krivanikm/mnpk01-soc/docs/schematics.md

---
title: Schematics
---

# Schematics

RTL schematics generated from the SystemVerilog code by **Yosys** (`make schematics` in `rtl/`).
Every block is drawn the way the synthesizer understands it: adders, multiplexers, registers and the wires between them.
Each schematic is an SVG, so it stays sharp at any zoom.

<p class="sv-hint">drag to move · + / − or Ctrl + wheel to zoom · double-click to zoom in · ⛶ fullscreen (the wheel zooms there)</p>

<figure class="schem">
  
  <figcaption><b>system_top</b> – how the control unit, register file, ALU, program counter and data RAM are connected. Note <code>r1_out</code> going straight into the <code>op</code> input of the ALU.</figcaption>
</figure>

<figure class="schem">
  
  <figcaption><b>Program counter</b> – a +1 adder, two multiplexers and a 16-bit register. The <code>pc_inc</code> multiplexer is closer to the register, so it has priority over <code>pc_load</code>.</figcaption>
</figure>

<figure class="schem">
  
  <figcaption><b>ALU</b> – the arithmetic and logic operations computed in parallel and a large multiplexer that picks one result by <code>op</code>.</figcaption>
</figure>

<figure class="schem">
  
  <figcaption><b>Control unit</b> – the state machine, the instruction register and the flags.</figcaption>
</figure>

<figure class="schem">
  
  <figcaption><b>Register file</b> – 16 × 16-bit registers and the multiplexer that selects the register being read. This is the largest block of the CPU.</figcaption>
</figure>

<figure class="schem">
  
  <figcaption><b>Data RAM</b> – a memory array with a write port and a registered read. The synthesizer maps it to FPGA block RAM.</figcaption>
</figure>

<figure class="schem">
  
  <figcaption><b>Whole CPU</b> – everything above flattened into a single diagram. Very large – use fullscreen and zoom in.</figcaption>
</figure>

## FPGA resources

Synthesis for the Gowin GW1NR-9 (Tang Nano 9K) with Yosys `synth_gowin`:

| Resource | CPU | Tang Nano 9K | Usage |
|---|---|---|---|
| Flip-flops | 396 | 6 480 | ~6 % |
| LUTs | 1 197 | 8 640 | ~14 % |
| Block RAM (BSRAM) | 4 | 26 | ~15 % |

Most of it is the register file: 256 bits of state and a 16-to-1 multiplexer 16 bits wide.
Most of the ~670 single-input LUTs are only constant helper inputs for the wide multiplexers that Yosys adds for Gowin; the real logic (LUT2 – LUT4) is about 530 LUTs.
The data RAM (4096 × 16 bits) takes 4 block RAMs and no flip-flops.

<script src="{{ '/assets/js/schem.js' | relative_url }}?v=1.3"></script>
