krivanikm/mnpk01-soc/docs/index.md

---
title: Home
---

# MNPK-01

**MNPK-01** is a 16-bit microcontroller designed from the logic level in SystemVerilog all the way to a physical printed circuit board.
The goal of the project is to cover the whole chain of computer design: a custom instruction set architecture (ISA), its hardware
implementation, verification by simulation, deployment on an FPGA and finally a custom PCB.

## Key parameters

| Parameter | Value |
|---|---|
| Data width | 16 bits (registers, ALU) |
| Address width | 16 bits |
| Instruction width | 16 bits (1 instruction = 1 word) |
| Registers | 16 × 16 bits (R0 – R15) |
| Data memory | 4096 × 16 bits RAM (FPGA block RAM), word-addressed |
| Architecture | Harvard – separate program and data memory |
| Input / output | memory-mapped at `0xFF00` – `0xFFFF`: 16-bit output port, 16-bit input port, UART transmitter and receiver |
| Program storage | FPGA BRAM, initialised from a hex file in the bitstream, new programs uploaded over UART |

## Project status

| Part | Status |
|---|---|
| ALU | done, 16-bit, 14 operations, ~40 million checks (edge and random values) |
| Register file | done |
| Program counter | done, connected in `system_top` |
| Control unit | all 9 instructions work (NOP, MVI, MOV, MVIB, LOAD, STORE, JMP, ALU, HLT), also with FPGA BRAM |
| ALU instruction (via register R1) | done |
| Jumps (JMP + 6 conditions) | done – loops and decisions work |
| LOAD/STORE + data RAM | done – arrays in memory work |
| Automated tests | 28/28 pass in both memory modes |
| I/O port | done – `STORE` to `0xFF00` drives the output, `LOAD` from `0xFF01` reads the input |
| UART transmitter | done – `STORE` to `0xFF01` sends a byte, `LOAD` from `0xFF02` reads `busy`, "Hello World" runs on the board |
| UART receiver | done – `LOAD` from `0xFF04` reads `rx_ready`, `LOAD` from `0xFF03` reads the byte, an echo program runs on the board |
| Program loader over UART | done – `MNPK` packet with length and XOR checksum, `tools/upload.py` loads a program into the running board |
| HLT instruction | done – stops the CPU, the board shows it on an LED |
| Assembler (`tools/asm/mnasm`) | done – C++, two passes, labels |
| New instructions (BR, ADDI, JAL) | next |
| Synthesis (Yosys) | design fits a Tang Nano 9K with ~14 % of its LUTs and 4 of 26 block RAMs, see [Schematics](schematics.html) |
| FPGA | done – the CPU runs on a Tang Nano 9K (LEDs, switches and UART through the I/O port), see [FPGA](fpga.html) |
| PCB | planned |
