krivanikm/mnpk01-soc/docs/simulation.md

---
title: Simulation
---

# Simulation and testing

The design is verified with the **Verilator** simulator, testbenches are written in C++.

## ALU test

File: `rtl/alu/sim_main.cpp`

With 16-bit operands there are too many combinations to try them all (65536 × 65536 per operation), so for every operation it tests:

1. all 65536 values of `a` against edge values of `b` (`0`, `1`, `0x7F`, `0x80`, `0xFF`, `0x100`, `0x7FFF`, `0x8000`, `0xFFFF`, …),
2. edge values of `a` against all 65536 values of `b`,
3. one million random pairs (with a fixed seed, so the test is always the same).

That is about **40 million checks**; both the result and the flags are compared with the values computed in C++.
Run it with `make alu` in `rtl/`.

## Full system test

Files: `rtl/tb_full_system.cpp`, `rtl/tests/*.txt`

Every test is a short program in its own text file together with the expected result:

```
1100    ; MVI R1, 0      (ADD)
123B    ; MVI R2, 59
1331    ; MVI R3, 49
7234    ; ALU R2, R3, R4
expect r2=59 r3=49 r4=108
```

The testbench loads the program, runs it and at the end compares the **actual contents of all 16 registers**
with the expected values. A register that is not listed must be 0, so a write to a wrong register is caught too.
It also checks the final PC and stops a program that gets stuck.
A test can also check the data RAM, e.g. `expect mem[0x10]=42` (only the listed addresses are checked).
The I/O ports work the same way: the line `io_in 0xA5C3` sets the input pins and `expect io_out=0x1234` checks the output register at the end of the test (a test that does not list `io_out` expects 0, so a stray write to the port is caught).

Every test runs in **both memory modes**:

| Mode | Behaviour |
|---|---|
| combinational | the instruction is available immediately |
| synchronous (BRAM) | like real FPGA block RAM: data arrive one cycle after the address |

The program counter is real hardware (`programcounter.v` in `system_top`); the testbench only emulates the program memory and serves it the instruction at address `pc`.

### Tests

| Test | What it checks |
|---|---|
| `basic` | MVI, MVIB, MOV, NOP together |
| `mvi_mvib` | 16-bit constants, registers R0 and R15, overwriting a value |
| `mov` | MOV copies all 16 bits, chaining, MOV to itself |
| `nop_unimplemented` | NOP and unknown opcodes (`0x8` – `0xF`) do not hang the CPU |
| `alu_add` | 59 + 49 = 108 |
| `alu_ops` | SUB, AND, OR, XOR, operation in R1 changed between instructions |
| `alu_sub_borrow` | subtraction below zero, subtraction to zero |
| `alu_cmp` | CMP does not write to Rd |
| `alu_rd_eq_src` | destination equal to a source register |
| `alu_unary` | INC, DEC, NOT, SHL, SHR, ROL, PASS, CLR |
| `alu_high_byte` | the ALU uses the high bytes of the operands and overwrites the whole Rd |
| `alu_carry16` | carry / borrow between the low and high byte, 16-bit overflow |
| `alu_op_runtime` | the ALU writes into R1 and so selects the next operation |
| `jmp_always` | unconditional jump forwards and backwards, skipped instructions are not executed |
| `jmp_cond` | all 6 conditions after CMP, each one taken and not taken; an unknown condition never jumps |
| `jmp_loop` | a loop: 6 × 7 = 42 by repeated addition, JNZ on the Z flag from SUB |
| `mem_store_load` | STORE and LOAD back, the same register as address and data, LOAD into the address register |
| `mem_back_to_back` | LOAD right after STORE and vice versa, swapping two values in memory |
| `mem_array` | an array of 5 numbers in RAM summed in a loop (LOAD + JMP) = 150 |
| `io_write` | `STORE` to `0xFF00` sets `io_out` and does not write into the RAM (it would alias to `0x0F00`) |
| `io_unmapped` | `STORE` to `0xFF01` (the UART data port) changes neither `io_out` nor the RAM |
| `io_and_ram` | a write to the port and a write to the RAM do not mix |
| `io_read` | `LOAD` from `0xFF01` returns `io_in` |
| `io_read_ram_mix` | alternating `LOAD` from the port and from the RAM, the port selection does not stay latched |
| `uart_send_busy` | `STORE` to `0xFF01` starts the UART (`busy` = 1 on the next `LOAD` from `0xFF02`) and nothing is written into the RAM |
| `uart_status_idle` | `LOAD` from `0xFF02` before any transmission returns `busy` = 0 |
| `uart_recv` | the CPU waits for `rx_ready`, reads a received byte from `0xFF03` and `rx_ready` is 0 afterwards |
| `uart_recv_two` | two bytes in a row; the second one arrives while the CPU is busy in a delay loop and its `rx_ready` must not be lost |

### Running

In the `rtl/` directory:

```
make test        # all tests, both memory modes
make test V=1    # with a cycle-by-cycle trace
make alu         # standalone ALU test
make uart        # standalone UART transmitter and receiver tests
```

Current result: **28/28 tests pass** in both modes.

### UART test

File: `rtl/uart/tb_uart_tx.cpp`

The transmitter is tested alone, with `CLKS_PER_BIT` = 16 so the simulation is short. For a set of bytes the testbench sends the byte,
samples the `tx` line in the middle of every bit and checks the start bit (0), the 8 data bits (least significant first) and the stop bit (1),
and also that `busy` is high for the whole frame and low again afterwards.

### UART receiver test

File: `rtl/uart/tb_uart_rx.cpp`

The receiver is tested alone, also with `CLKS_PER_BIT` = 16. The testbench drives the `rx` line with a start bit, 8 data bits (least significant first) and a stop bit, each held for `CLKS_PER_BIT` clocks, and checks that `valid` pulses exactly once and `data` equals the sent byte.
It sends the bytes 0x41, 0x55, 0xAA, 0x00, 0xFF, 0x80 and 0x01, then a start bit lasting only a quarter of the bit time (a glitch that must be rejected), and finally two frames back to back, which must give two `valid` pulses.

In the full-system testbench (`tb_full_system.cpp`) the line `rx 0x5A 0xA5` in a test file drives `uart_rx_pin` with those bytes, one frame after another, starting at clock 50.
