krivanikm/mnpk01-soc/docs/architecture.md

---
title: Architecture
---

# Architecture

```
              +-----------------+
   UART boot- |  Program memory | 16-bit instruction
   loader --> |     (BRAM)      | ------------------+
              +-----------------+                   |
                       ^ 16-bit address             v
              +-----------------+          +-----------------+  address, data  +-----------------+
              | Program counter | <------- |  Control unit   | <-------------> |    Data RAM     |
              +-----------------+   jump   +-----------------+   LOAD/STORE    | 4K x 16 (BRAM)  |
                                             |      |      ^                   +-----------------+
                                   control   |      |      | flags Z/C/N
                                             v      v      |
                                  +---------------+  +-----------+
                                  | Register file |<>|    ALU    |
                                  |  16 x 16 bit  |  |  16 bit   |
                                  +---------------+  +-----------+
```

The control unit drives all blocks directly, there is no bus-management unit between them.
The ALU takes its operation code straight from register R1 (see [ALU](alu.html)).

## Program counter

File: `rtl/program-counter/programcounter.v`

A 16-bit register holding the address of the current instruction.

| Signal | Direction | Meaning |
|---|---|---|
| `clk`, `rst` | input | clock, asynchronous reset (PC = 0) |
| `pc_inc` | input | PC = PC + 1 |
| `pc_load` | input | PC = `d_in` (jump) |
| `d_in[15:0]` | input | jump target address |
| `pc[15:0]` | output | current address |

If `pc_inc` and `pc_load` are both 1, `pc_inc` wins – the jump is not taken.
The control unit never sets both at once: `pc_inc` only in `S_FETCH`, `pc_load` only in `S_JMP`.
The program counter is part of `system_top`; its output `pc` is the address for the program memory.

## Register file

File: `rtl/registers/register_file.sv`

16 registers of 16 bits each. A register is always **read as a whole 16-bit word**.
Writing has two enable bits, one per byte, so the control unit can write the low byte (MVI),
the high byte (MVIB) or the whole word (MOV, ALU).

| Signal | Direction | Meaning |
|---|---|---|
| `clk`, `rst_n` | input | clock, asynchronous active-low reset, clears all registers |
| `addr[3:0]` | input | register number R0 – R15 |
| `d_in[15:0]` | input | data to write |
| `write_en[1:0]` | input | write on the rising clock edge: `01` = low byte `[7:0]`, `10` = high byte `[15:8]`, `11` = whole word |
| `q_out[15:0]` | output | register read (combinational, valid right after the address changes) |
| `r1_out[3:0]` | output | `R1[3:0]`, wired straight to the ALU as the operation code |

## Data RAM

File: `rtl/memory/data_ram.sv`

4096 words of 16 bits, implemented in FPGA block RAM (4 BSRAM blocks on the Tang Nano 9K).
It is **synchronous**: both write and read happen on the rising clock edge, so read data are valid one cycle after the address.
The memory array has no reset on purpose – with a reset the synthesizer could not map it to block RAM and would use
65 536 flip-flops instead.

| Signal | Direction | Meaning |
|---|---|---|
| `clk` | input | clock |
| `addr[11:0]` | input | word address (the low 12 bits of the address from the register) |
| `din[15:0]` | input | data to write |
| `we` | input | 1 = write `din` to `addr` on the rising edge |
| `dout[15:0]` | output | data read from `addr`, valid one cycle later |

The RAM only sees the low 12 bits of the address; the I/O area `0xFF00` – `0xFFFF` is decoded in `system_top` before the RAM (see [Input / output](#input--output)).

## Input / output

Input and output are **memory-mapped**: the same `LOAD` and `STORE` instructions that access the RAM also reach the ports, there is no separate I/O instruction.
`system_top` decodes the full 16-bit address of the memory access:

```
io_sel = (mem_addr[15:8] == 8'hFF)          the address is in 0xFF00 – 0xFFFF
RAM write enable = mem_we && !io_sel         a STORE to the I/O area never writes into the RAM
io_out <= mem_wdata   when mem_we && mem_addr == 16'hFF00
```

| Port | Direction | Address | Description |
|---|---|---|---|
| `io_out[15:0]` | output | `0xFF00` (STORE) | a 16-bit register, reset to 0 |
| `io_in[15:0]` | input | `0xFF01` (LOAD) | value of the pins, read through the multiplexer |
| UART data | output | `0xFF01` (STORE) | the low byte is sent over the `uart_tx_pin` pin; ignored while the UART is busy |
| UART status | input | `0xFF02` (LOAD) | bit 0 = `busy` (1 while a byte is being sent), the other bits are 0 |
| UART receive data | input | `0xFF03` (LOAD) | the low 8 bits = the last received byte; reading it clears `rx_ready` |
| UART receive status | input | `0xFF04` (LOAD) | bit 0 = `rx_ready` (1 = a new byte is waiting), the other bits are 0 |

`0xFF01` has a different meaning for each direction: `STORE` starts the UART, `LOAD` reads the input pins.
Any `LOAD` from the I/O area except `0xFF02` – `0xFF04` returns `io_in`, the address is not decoded more precisely.

**Read path.** The RAM is synchronous, so LOAD waits one cycle for the data (`S_LOAD_WAIT`). The input port has to answer with the same delay:
`system_top` registers both `io_sel` and `io_in` in the cycle in which the RAM latches the address and then selects between the RAM output and the port:

```
if (!io_sel_q) w_mem_rdata = ram_dout
else case (io_addr_q)
    8'h02:   w_mem_rdata = {15'b0, uart_busy}
    8'h03:   w_mem_rdata = {8'b0, rx_data}
    8'h04:   w_mem_rdata = {15'b0, rx_ready}
    default: w_mem_rdata = io_in_q
```

`io_addr_q` is the registered low byte of `mem_addr`, so the UART registers also arrive with the same delay as RAM data.
Without this the CU would read the previous value of the port instead of the current one.
The tests `io_read` and `io_read_ram_mix` check exactly that, including alternating LOADs from the port and from the RAM.

### UART transmitter

File: `rtl/uart/uart_tx.sv`

A transmitter for the 8N1 format (1 start bit, 8 data bits starting with the least significant one, 1 stop bit, no parity).
The parameter `CLKS_PER_BIT` is the number of clocks per bit: 27 MHz / 115 200 Bd = 234 (the default).

| Signal | Direction | Meaning |
|---|---|---|
| `clk`, `rst` | input | clock, synchronous reset (line idle at 1) |
| `data[7:0]` | input | byte to send, latched when `start` = 1 |
| `start` | input | 1 for one clock in `IDLE` starts the transmission |
| `tx` | output | serial line, idle level 1 |
| `busy` | output | 1 in every state except `IDLE` |

The FSM has four states: `IDLE -> START -> DATA -> STOP -> IDLE`, a counter `clk_cnt` counts the clocks inside one bit and `bit_idx` the data bit.
One byte takes 10 bits, i.e. about 87 µs at 115 200 Bd, which is thousands of CPU cycles.

In `system_top`: `uart_start = mem_we && mem_addr == 0xFF01 && !uart_busy`, the data are `mem_wdata[7:0]`.
The UART has no buffer, so a program has to wait for `busy` = 0 before every byte, otherwise the byte is lost. Sending one character:

```
wait:  LOAD  R6, [R3]      ; R3 = 0xFF02, R6 = busy
       ...                 ; R6 != 0 -> jump back to wait
       STORE R5, [R2]      ; R2 = 0xFF01, send the low byte of R5
```

### UART receiver

File: `rtl/uart/uart_rx.sv`

A receiver for the same 8N1 format, with the same `CLKS_PER_BIT` parameter (234 by default).

| Signal | Direction | Meaning |
|---|---|---|
| `clk`, `rst` | input | clock, synchronous reset |
| `rx` | input | serial line, idle level 1 |
| `data[7:0]` | output | the received byte, valid while `valid` = 1 |
| `valid` | output | 1 for one clock when a whole byte has been received |

The `rx` pin is asynchronous to the clock, so it first goes through two flip-flops (`rx_sync1`, `rx_sync2`) against metastability.
The FSM has the same four states as the transmitter, `IDLE -> START -> DATA -> STOP -> IDLE`:

- `IDLE`: waits for `rx_sync2` = 0 (the falling edge of the start bit) and clears `clk_cnt`.
- `START`: waits half a bit (`CLKS_PER_BIT/2`), so it stands in the middle of the start bit. If the line is still 0, it continues. If not, it was a glitch and the FSM returns to `IDLE`.
- `DATA`: waits a whole bit, i.e. always lands in the middle of the next bit, and stores `rx_sync2` into `data[bit_idx]`. The least significant bit comes first.
- `STOP`: waits one more bit, sets `valid` for one clock and returns to `IDLE`.

Sampling in the middle of each bit is the farthest from the edges, so it tolerates a small difference between the two baud rates.

In `system_top` the byte is stored into `rx_data` and `rx_ready` is set to 1 when `valid` arrives. `rx_ready` is cleared when the CU reads the port `0xFF03` (in the state `S_LOAD_WRITE`).
It is cleared only in that one state, not whenever the address is `0xFF03`: the address stays on the bus after the `LOAD`, and a byte arriving in the meantime would lose its flag at once.
If a new byte arrives before the previous one was read, it overwrites `rx_data`; there is no buffer. Receiving one character:

```
wait:  LOAD  R6, [R2]      ; R2 = 0xFF04, R6 = rx_ready
       ...                 ; R6 == 0 -> jump back to wait
       LOAD  R7, [R3]      ; R3 = 0xFF03, R7 = the received byte
```

## Bootloader

File: `rtl/boot/bootloader.sv`

The bootloader loads a program into the program memory over the UART, so the bitstream does not have to be rebuilt for every program. It has its own `uart_rx` on the same `rx` pin as the CPU.

| Signal | Direction | Meaning |
|---|---|---|
| `clk`, `rst` | input | clock, synchronous reset |
| `rx` | input | serial line |
| `cpu_rst` | output | 1 while the program is being loaded, holds the CPU in reset |
| `we`, `waddr[7:0]`, `wdata[15:0]` | output | write port of the program memory |
| `done_ok` | output | 1 after a program with a correct checksum was loaded |
| `done_err` | output | 1 after a wrong checksum or a rejected length |

The packet, sent at 115200 baud (8N1):

| Bytes | Meaning |
|---|---|
| `M N P K` | start marker (ASCII) |
| 2 | number of words `n`, high byte first; allowed 1 to 256 |
| 2 * n | the program, each word high byte first |
| 1 | checksum: XOR of all the data bytes (not of the marker and the length) |

The FSM waits in `IDLE -> GOT_M -> GOT_N -> GOT_P` for the marker. A wrong byte returns it to `IDLE`, an `M` in any of the marker states starts the marker again, so `MMNPK` works too. After `K` it sets `cpu_rst` = 1 and clears `done_ok` and `done_err`.
Then `LEN_HI` and `LEN_LO` read the length. If it is 0 or more than 256, it sets `done_err` and returns to `IDLE` (the CPU stays in reset). Otherwise `DATA_HI` and `DATA_LO` collect a word, write it to the next address (`we` = 1 for one clock) and XOR both bytes into the checksum.
`CHK` compares the last byte with the checksum. If they are equal, `done_ok` = 1 and `cpu_rst` = 0, so the CPU starts from address 0 with the new program. If not, `done_err` = 1 and the CPU stays in reset until a new, correct packet arrives.

While `cpu_rst` = 1, the UART receiver of the CPU is in reset too, so it does not see the bytes of the packet. The tests are in `rtl/boot/tb_bootloader.cpp` (`make boot` in `rtl/`): marker variants, programs of 1, 3 and 256 words, a wrong checksum, lengths 0 and 257, and two uploads in a row.

## Control unit

File: `rtl/control-unit/controlunit.sv`

A finite state machine (FSM) that walks through these states for every instruction:

```
S_FETCH -> S_DECODE -> execute states -> S_FETCH
```

| State | What happens |
|---|---|
| `S_FETCH` | instruction is read from program memory |
| `S_DECODE` | opcode is decoded, next state is chosen |
| `S_NOP` | empty cycle while the PC advances |
| `S_MVI_WRITE` | constant is written to a register (both MVI and MVIB) |
| `S_MOV_LATCH` | source register is read into a temporary register |
| `S_MOV_WRITE` | value is written to the destination register |
| `S_ALU_A` | operand Ra is stored, Rb is selected |
| `S_ALU_B` | ALU result is written to Rd (except CMP), flags are stored |
| `S_JMP` | target register is read; if the condition holds: `pc_addr` = target, `pc_load` = 1 |
| `S_JMP_WAIT1` | the PC takes the target address at the end of the cycle |
| `S_JMP_WAIT2` | the memory latches the target address at the end of the cycle |
| `S_STORE_ADDR` | address register Ra is read into `mem_addr`, data register Rs is selected |
| `S_STORE_DATA` | Rs goes to `mem_wdata`, `mem_we` = 1 – the RAM writes at the end of the next cycle |
| `S_LOAD_ADDR` | address register Ra is read into `mem_addr` |
| `S_LOAD_WAIT` | the RAM latches the address at the end of the cycle |
| `S_LOAD_WRITE` | data from the RAM are written to Rd |

The state register has 5 bits (16 states are used, so the next one would not fit into 4 bits).

### Timing rule

The program memory in the FPGA (BRAM) is synchronous: data for a new address arrive one cycle later.
`S_FETCH` therefore stores the whole instruction in the instruction register and immediately sets `pc_inc`;
the following states only use the instruction register, so the memory fetches the next instruction in the meantime:

| Cycle | State | |
|---|---|---|
| 1 | `S_FETCH` | instruction → instruction register, `pc_inc` = 1 |
| 2 | `S_DECODE` | PC advances at the end of the cycle |
| 3 | execute | the memory latches the new address at the end of the cycle |
| 4 | `S_FETCH` | the next instruction is valid |

Rule: `pc_inc` is set **only** in `S_FETCH` and every instruction takes **at least 3 cycles**
(that is why NOP goes through `S_NOP`).

### Jump timing

The outputs of the control unit are registered and the memory is synchronous, so a taken jump needs two extra cycles
before the instruction at the target address T can be fetched:

| Cycle | State | What happens | PC | Memory latches |
|---|---|---|---|---|
| 1 | `S_FETCH` | JMP → instruction register, `pc_inc` = 1 | J | J |
| 2 | `S_DECODE` | register address ← Rr | J → J+1 | J |
| 3 | `S_JMP` | target is read, `pc_load` = 1 (if the condition holds) | J+1 | J+1 |
| 4 | `S_JMP_WAIT1` | PC takes the target at the end of the cycle | J+1 → T | J+1 |
| 5 | `S_JMP_WAIT2` | | T | **T** |
| 6 | `S_FETCH` | the instruction at T is valid | T | |

A jump that is **not taken** goes from `S_JMP` straight back to `S_FETCH` – the PC already points past the JMP,
so it takes 3 cycles like any other short instruction.

The condition is evaluated by the combinational signal `cond_ok` from `ir[11:8]` and the stored flags.

### LOAD / STORE timing

The register file has a single read port, so STORE reads its two registers (address and data) one after another.
LOAD has to wait one cycle for the synchronous RAM:

| Cycle | STORE | LOAD |
|---|---|---|
| 1 | `S_FETCH` | `S_FETCH` |
| 2 | `S_DECODE` – register address ← Ra | `S_DECODE` – register address ← Ra |
| 3 | `S_STORE_ADDR` – `mem_addr` ← Ra, register address ← Rs | `S_LOAD_ADDR` – `mem_addr` ← Ra |
| 4 | `S_STORE_DATA` – `mem_wdata` ← Rs, `mem_we` = 1 | `S_LOAD_WAIT` – the RAM latches the address |
| 5 | (next `S_FETCH`, the RAM writes at the end of the cycle) | `S_LOAD_WRITE` – Rd ← `mem_rdata` |

STORE takes **4 cycles**, LOAD **5 cycles**.

## Schematics

RTL schematics of every block generated by Yosys are on the [Schematics](schematics.html) page.
