krivanikm/mnpk01-soc/docs/sk/architecture.md

---
title: Architektúra
lang: sk
---

# Architektúra

```
              +-----------------+
   UART boot- |  Pamäť programu | 16-bit inštrukcia
   loader --> |     (BRAM)      | ------------------+
              +-----------------+                   |
                       ^ 16-bit adresa              v
              +-----------------+          +-----------------+   adresa, dáta  +-----------------+
              | Program counter | <------- |  Control unit   | <-------------> |  Dátová RAM     |
              +-----------------+   skok   +-----------------+   LOAD/STORE    | 4K x 16 (BRAM)  |
                                             |      |      ^                   +-----------------+
                                  riadenie   |      |      | flagy Z/C/N
                                             v      v      |
                                  +---------------+  +-----------+
                                  | Register file |<>|    ALU    |
                                  |  16 x 16 bit  |  |  16 bit   |
                                  +---------------+  +-----------+
```

Control unit riadi všetky bloky priamo, nie je medzi nimi žiadna zbernicová jednotka.
ALU berie kód operácie priamo z registra R1 (pozri [ALU](alu.html)).

## Program counter

Súbor: `rtl/program-counter/programcounter.v`

16-bitový register s adresou aktuálnej inštrukcie.

| Signál | Smer | Význam |
|---|---|---|
| `clk`, `rst` | vstup | hodiny, asynchrónny reset (PC = 0) |
| `pc_inc` | vstup | PC = PC + 1 |
| `pc_load` | vstup | PC = `d_in` (skok) |
| `d_in[15:0]` | vstup | cieľová adresa skoku |
| `pc[15:0]` | výstup | aktuálna adresa |

Ak sú `pc_inc` aj `pc_load` naraz 1, vyhrá `pc_inc` – skok sa nevykoná.
Control unit ich nikdy nenastaví naraz: `pc_inc` iba v `S_FETCH`, `pc_load` iba v `S_JMP`.
Program counter je súčasťou `system_top`, jeho výstup `pc` je adresa pre pamäť programu.

## Register file

Súbor: `rtl/registers/register_file.sv`

16 registrov po 16 bitoch. Z registra sa vždy **číta celé 16-bitové slovo**.
Zápis má dva povoľovacie bity, jeden pre každý bajt, takže control unit vie zapísať dolný bajt (MVI),
horný bajt (MVIB) alebo celé slovo (MOV, ALU).

| Signál | Smer | Význam |
|---|---|---|
| `clk`, `rst_n` | vstup | hodiny, asynchrónny reset (aktívny v 0), vynuluje všetky registre |
| `addr[3:0]` | vstup | číslo registra R0 – R15 |
| `d_in[15:0]` | vstup | zapisované dáta |
| `write_en[1:0]` | vstup | zápis na nábežnej hrane hodín: `01` = dolný bajt `[7:0]`, `10` = horný bajt `[15:8]`, `11` = celé slovo |
| `q_out[15:0]` | výstup | čítaný register (kombinačne, hneď po zmene adresy) |
| `r1_out[3:0]` | výstup | `R1[3:0]`, ide priamo do ALU ako kód operácie |

## Dátová RAM

Súbor: `rtl/memory/data_ram.sv`

4096 slov po 16 bitoch, realizovaných v blokovej pamäti FPGA (na Tang Nano 9K 4 bloky BSRAM).
Je **synchrónna**: zápis aj čítanie prebieha na nábežnej hrane hodín, prečítané dáta sú teda platné takt po adrese.
Pole pamäte zámerne nemá reset – s resetom by ho syntéza nevedela namapovať na blokovú pamäť
a použila by namiesto nej 65 536 klopných obvodov.

| Signál | Smer | Význam |
|---|---|---|
| `clk` | vstup | hodiny |
| `addr[11:0]` | vstup | adresa slova (dolných 12 bitov adresy z registra) |
| `din[15:0]` | vstup | zapisované dáta |
| `we` | vstup | 1 = na nábežnej hrane zapíš `din` na `addr` |
| `dout[15:0]` | výstup | dáta z `addr`, platné o takt neskôr |

RAM vidí len dolných 12 bitov adresy; oblasť I/O `0xFF00` – `0xFFFF` sa dekóduje v `system_top` pred RAM (pozri [Vstup a výstup](#vstup-a-výstup)).

## Vstup a výstup

Vstup a výstup sú **mapované do pamäte**: tie isté inštrukcie `LOAD` a `STORE`, ktoré pristupujú k RAM, sa dostanú aj k portom, samostatná I/O inštrukcia neexistuje.
`system_top` dekóduje celú 16-bitovú adresu prístupu do pamäte:

```
io_sel = (mem_addr[15:8] == 8'hFF)          adresa je v 0xFF00 – 0xFFFF
zápis do RAM = mem_we && !io_sel             STORE do oblasti I/O sa nikdy nezapíše do RAM
io_out <= mem_wdata   keď mem_we && mem_addr == 16'hFF00
```

| Port | Smer | Adresa | Popis |
|---|---|---|---|
| `io_out[15:0]` | výstup | `0xFF00` (STORE) | 16-bitový register, po resete 0 |
| `io_in[15:0]` | vstup | `0xFF01` (LOAD) | hodnota pinov, čítaná cez multiplexor |
| dáta UART | výstup | `0xFF01` (STORE) | dolný bajt sa odošle na pin `uart_tx_pin`; ignoruje sa, kým je UART zaneprázdnený |
| stav UART | vstup | `0xFF02` (LOAD) | bit 0 = `busy` (1, kým sa odosiela bajt), ostatné bity sú 0 |
| prijaté dáta UART | vstup | `0xFF03` (LOAD) | dolných 8 bitov = posledný prijatý bajt; čítanie vynuluje `rx_ready` |
| stav príjmu UART | vstup | `0xFF04` (LOAD) | bit 0 = `rx_ready` (1 = čaká nový bajt), ostatné bity sú 0 |

Adresa `0xFF01` znamená pre každý smer niečo iné: `STORE` spustí UART, `LOAD` číta vstupné piny.
Každý `LOAD` z oblasti I/O okrem `0xFF02` – `0xFF04` vráti `io_in`, adresa sa nedekóduje presnejšie.

**Čítanie.** RAM je synchrónna, takže LOAD čaká jeden takt na dáta (`S_LOAD_WAIT`). Vstupný port musí odpovedať s rovnakým oneskorením:
`system_top` zaregistruje `io_sel` aj `io_in` v takte, v ktorom RAM zachytáva adresu, a potom vyberie medzi výstupom RAM a portom:

```
if (!io_sel_q) w_mem_rdata = ram_dout
else case (io_addr_q)
    8'h02:   w_mem_rdata = {15'b0, uart_busy}
    8'h03:   w_mem_rdata = {8'b0, rx_data}
    8'h04:   w_mem_rdata = {15'b0, rx_ready}
    default: w_mem_rdata = io_in_q
```

`io_addr_q` je zaregistrovaný dolný bajt `mem_addr`, takže aj registre UART prídu s rovnakým oneskorením ako dáta z RAM.
Bez toho by CU prečítala predošlú hodnotu portu namiesto aktuálnej.
Testy `io_read` a `io_read_ram_mix` kontrolujú presne toto, vrátane striedavých LOAD z portu a z RAM.

### Vysielač UART

Súbor: `rtl/uart/uart_tx.sv`

Vysielač vo formáte 8N1 (1 štart bit, 8 dátových bitov od najnižšieho, 1 stop bit, bez parity).
Parameter `CLKS_PER_BIT` je počet taktov na jeden bit: 27 MHz / 115 200 Bd = 234 (predvolená hodnota).

| Signál | Smer | Význam |
|---|---|---|
| `clk`, `rst` | vstup | hodiny, synchrónny reset (linka v kľude je 1) |
| `data[7:0]` | vstup | bajt na odoslanie, zachytí sa pri `start` = 1 |
| `start` | vstup | 1 na jeden takt v stave `IDLE` spustí vysielanie |
| `tx` | výstup | sériová linka, kľudová úroveň 1 |
| `busy` | výstup | 1 v každom stave okrem `IDLE` |

FSM má štyri stavy: `IDLE -> START -> DATA -> STOP -> IDLE`, počítadlo `clk_cnt` počíta takty v rámci jedného bitu a `bit_idx` dátový bit.
Jeden bajt trvá 10 bitov, teda pri 115 200 Bd približne 87 µs, čo sú tisíce taktov procesora.

V `system_top`: `uart_start = mem_we && mem_addr == 0xFF01 && !uart_busy`, dáta sú `mem_wdata[7:0]`.
UART nemá buffer, takže program musí pred každým bajtom počkať na `busy` = 0, inak sa bajt stratí. Odoslanie jedného znaku:

```
wait:  LOAD  R6, [R3]      ; R3 = 0xFF02, R6 = busy
       ...                 ; R6 != 0 -> skok späť na wait
       STORE R5, [R2]      ; R2 = 0xFF01, odošle dolný bajt R5
```

### Prijímač UART

Súbor: `rtl/uart/uart_rx.sv`

Prijímač pre rovnaký formát 8N1 a s rovnakým parametrom `CLKS_PER_BIT` (predvolene 234).

| Signál | Smer | Význam |
|---|---|---|
| `clk`, `rst` | vstup | hodiny, synchrónny reset |
| `rx` | vstup | sériová linka, v pokoji 1 |
| `data[7:0]` | výstup | prijatý bajt, platný, kým je `valid` = 1 |
| `valid` | výstup | 1 na jeden takt, keď je celý bajt prijatý |

Pin `rx` je asynchrónny voči hodinám, preto najprv prejde cez dva flip-flopy (`rx_sync1`, `rx_sync2`) proti metastabilite.
FSM má rovnaké štyri stavy ako vysielač, `IDLE -> START -> DATA -> STOP -> IDLE`:

- `IDLE`: čaká na `rx_sync2` = 0 (zostupná hrana štart bitu) a nuluje `clk_cnt`.
- `START`: počká pol bitu (`CLKS_PER_BIT/2`), takže stojí v strede štart bitu. Ak je linka stále 0, pokračuje. Ak nie, bol to šum a FSM sa vráti do `IDLE`.
- `DATA`: počká celý bit, čiže vždy pristane v strede ďalšieho bitu, a uloží `rx_sync2` do `data[bit_idx]`. Najprv príde najnižší bit.
- `STOP`: počká ešte jeden bit, nastaví `valid` na jeden takt a vráti sa do `IDLE`.

Vzorkovanie v strede každého bitu je najďalej od hrán, takže znesie malý rozdiel medzi oboma prenosovými rýchlosťami.

V `system_top` sa po príchode `valid` bajt uloží do `rx_data` a `rx_ready` sa nastaví na 1. `rx_ready` sa vynuluje, keď CU číta port `0xFF03` (v stave `S_LOAD_WRITE`).
Nuluje sa len v tomto jedinom stave, nie vždy keď je adresa `0xFF03`: adresa po `LOAD` zostáva na zbernici a bajt, ktorý by medzitým prišiel, by o príznak hneď prišiel.
Ak príde nový bajt skôr, ako sa prečíta predošlý, prepíše `rx_data`; buffer tam nie je. Príjem jedného znaku:

```
wait:  LOAD  R6, [R2]      ; R2 = 0xFF04, R6 = rx_ready
       ...                 ; R6 == 0 -> skok späť na wait
       LOAD  R7, [R3]      ; R3 = 0xFF03, R7 = prijatý bajt
```

## Bootloader

Súbor: `rtl/boot/bootloader.sv`

Bootloader nahrá program do pamäte programu cez UART, takže netreba pre každý program znova zostavovať bitstream. Má vlastný `uart_rx` na rovnakom pine `rx` ako procesor.

| Signál | Smer | Význam |
|---|---|---|
| `clk`, `rst` | vstup | hodiny, synchrónny reset |
| `rx` | vstup | sériová linka |
| `cpu_rst` | výstup | 1 počas nahrávania programu, drží procesor v resete |
| `we`, `waddr[7:0]`, `wdata[15:0]` | výstup | zápisový port pamäte programu |
| `done_ok` | výstup | 1 po nahratí programu so správnym checksumom |
| `done_err` | výstup | 1 po zlom checksume alebo zamietnutej dĺžke |

Paket, posielaný rýchlosťou 115200 baud (8N1):

| Bajty | Význam |
|---|---|
| `M N P K` | začiatočná značka (ASCII) |
| 2 | počet slov `n`, najprv horný bajt; povolené 1 až 256 |
| 2 * n | program, každé slovo najprv horným bajtom |
| 1 | checksum: XOR všetkých dátových bajtov (nie značky a dĺžky) |

Automat čaká v stavoch `IDLE -> GOT_M -> GOT_N -> GOT_P` na značku. Zlý bajt ho vráti do `IDLE`, `M` v ktoromkoľvek stave značky začne značku odznova, takže funguje aj `MMNPK`. Po `K` nastaví `cpu_rst` = 1 a vynuluje `done_ok` a `done_err`.
Potom `LEN_HI` a `LEN_LO` načítajú dĺžku. Ak je 0 alebo viac ako 256, nastaví `done_err` a vráti sa do `IDLE` (procesor ostáva v resete). Inak `DATA_HI` a `DATA_LO` poskladajú slovo, zapíšu ho na ďalšiu adresu (`we` = 1 na jeden takt) a oba bajty XORujú do checksumu.
`CHK` porovná posledný bajt s checksumom. Ak sa rovnajú, `done_ok` = 1 a `cpu_rst` = 0, takže procesor štartuje od adresy 0 s novým programom. Ak nie, `done_err` = 1 a procesor ostáva v resete, kým nepríde nový, správny paket.

Kým je `cpu_rst` = 1, je v resete aj UART prijímač procesora, takže bajty paketu nevidí. Testy sú v `rtl/boot/tb_bootloader.cpp` (`make boot` v `rtl/`): varianty značky, programy s 1, 3 a 256 slovami, zlý checksum, dĺžky 0 a 257 a dve nahratia po sebe.

## Control unit

Súbor: `rtl/control-unit/controlunit.sv`

Konečný automat (FSM), ktorý pre každú inštrukciu prechádza stavmi:

```
S_FETCH -> S_DECODE -> stavy vykonania -> S_FETCH
```

| Stav | Čo sa deje |
|---|---|
| `S_FETCH` | načítanie inštrukcie z pamäte programu |
| `S_DECODE` | dekódovanie opcode, výber ďalšieho stavu |
| `S_NOP` | prázdny takt, kým sa posunie PC |
| `S_MVI_WRITE` | zápis konštanty do registra (MVI aj MVIB) |
| `S_MOV_LATCH` | prečítanie zdrojového registra do pomocného registra |
| `S_MOV_WRITE` | zápis do cieľového registra |
| `S_ALU_A` | uloženie operandu Ra, výber Rb |
| `S_ALU_B` | zápis výsledku ALU do Rd (okrem CMP), uloženie flagov |
| `S_JMP` | prečíta sa cieľový register; ak platí podmienka: `pc_addr` = cieľ, `pc_load` = 1 |
| `S_JMP_WAIT1` | PC na konci taktu prevezme cieľovú adresu |
| `S_JMP_WAIT2` | pamäť na konci taktu zachytí cieľovú adresu |
| `S_STORE_ADDR` | adresový register Ra sa prečíta do `mem_addr`, vyberie sa dátový register Rs |
| `S_STORE_DATA` | Rs ide do `mem_wdata`, `mem_we` = 1 – RAM zapíše na konci ďalšieho taktu |
| `S_LOAD_ADDR` | adresový register Ra sa prečíta do `mem_addr` |
| `S_LOAD_WAIT` | RAM na konci taktu zachytí adresu |
| `S_LOAD_WRITE` | dáta z RAM sa zapíšu do Rd |

Register stavu má 5 bitov (stavov je 16, ďalší by sa do 4 bitov už nezmestil).

### Pravidlo časovania

Pamäť programu vo FPGA (BRAM) je synchrónna: dáta pre novú adresu prídu až o takt neskôr.
`S_FETCH` preto uloží celú inštrukciu do inštrukčného registra a hneď nastaví `pc_inc`;
ďalšie stavy už používajú len inštrukčný register, takže pamäť medzitým načítava ďalšiu inštrukciu:

| Takt | Stav | |
|---|---|---|
| 1 | `S_FETCH` | inštrukcia → inštrukčný register, `pc_inc` = 1 |
| 2 | `S_DECODE` | PC sa na konci taktu posunie |
| 3 | vykonanie | pamäť na konci taktu zachytí novú adresu |
| 4 | `S_FETCH` | ďalšia inštrukcia je platná |

Pravidlo: `pc_inc` sa nastavuje **iba** v `S_FETCH` a každá inštrukcia trvá **aspoň 3 takty**
(preto NOP ide cez `S_NOP`).

### Časovanie skoku

Výstupy control unit sú registrované a pamäť je synchrónna, preto skok, ktorý sa vykoná, potrebuje dva takty navyše,
kým sa dá načítať inštrukcia z cieľovej adresy T:

| Takt | Stav | Čo sa deje | PC | Pamäť zachytí |
|---|---|---|---|---|
| 1 | `S_FETCH` | JMP → inštrukčný register, `pc_inc` = 1 | J | J |
| 2 | `S_DECODE` | adresa registra ← Rr | J → J+1 | J |
| 3 | `S_JMP` | prečíta sa cieľ, `pc_load` = 1 (ak platí podmienka) | J+1 | J+1 |
| 4 | `S_JMP_WAIT1` | PC na konci taktu prevezme cieľ | J+1 → T | J+1 |
| 5 | `S_JMP_WAIT2` | | T | **T** |
| 6 | `S_FETCH` | inštrukcia z adresy T je platná | T | |

Skok, ktorý sa **nevykoná**, ide z `S_JMP` rovno späť do `S_FETCH` – PC už ukazuje za JMP,
takže trvá 3 takty ako ktorákoľvek iná krátka inštrukcia.

Podmienku vyhodnocuje kombinačný signál `cond_ok` z `ir[11:8]` a uložených flagov.

### Časovanie LOAD / STORE

Register file má jeden čítací port, preto STORE číta svoje dva registre (adresu a dáta) postupne.
LOAD musí počkať jeden takt na synchrónnu RAM:

| Takt | STORE | LOAD |
|---|---|---|
| 1 | `S_FETCH` | `S_FETCH` |
| 2 | `S_DECODE` – adresa registra ← Ra | `S_DECODE` – adresa registra ← Ra |
| 3 | `S_STORE_ADDR` – `mem_addr` ← Ra, adresa registra ← Rs | `S_LOAD_ADDR` – `mem_addr` ← Ra |
| 4 | `S_STORE_DATA` – `mem_wdata` ← Rs, `mem_we` = 1 | `S_LOAD_WAIT` – RAM zachytí adresu |
| 5 | (ďalší `S_FETCH`, RAM zapíše na konci taktu) | `S_LOAD_WRITE` – Rd ← `mem_rdata` |

STORE trvá **4 takty**, LOAD **5 taktov**.

## Schémy

RTL schémy všetkých blokov vygenerované nástrojom Yosys sú na stránke [Schémy](schematics.html).
