krivanikm/mnpk01-soc/rtl/system_top.sv

module system_top (
    input  wire        clk,
    input  wire        rst,
    input  wire [15:0] rom_data,
    input  wire [15:0] io_in,
    input  wire        uart_rx_pin,

    
    output wire [4:0]  state_out,
    output wire        pc_inc,
    output wire [1:0]  write_reg_en,
    output wire [3:0]  reg_addr,
    output wire [15:0] reg_data,
    output wire [15:0] reg_q_out,
    output wire [15:0] pc,
    output reg [15:0] io_out,
    output wire        uart_tx_pin,
    output wire        halted
);

    wire        w_pc_inc;
    wire [1:0]  w_write_reg_en;
    wire [3:0]  w_reg_addr;
    wire [15:0] w_reg_data;
    wire [15:0] w_reg_q_out;
    wire [15:0] ram_dout;

    reg         io_sel_q;
    reg  [15:0] io_in_q;
    reg  [7:0]  io_addr_q;
    reg  [7:0]  rx_data;
    reg         rx_ready;

    wire [3:0]  w_alu_op;
    wire [15:0] w_alu_a;
    wire [15:0] w_alu_out;
    wire        w_z_flag;
    wire        w_c_flag;
    wire        w_n_flag;
    wire        w_pc_load;
    wire [15:0] w_pc_addr;
    wire [15:0] w_mem_addr;
    wire        w_mem_we;
    reg  [15:0] w_mem_rdata;
    wire [15:0] w_mem_wdata;
    wire        uart_busy;
    wire        uart_start;
    wire [7:0]  rx_byte;
    wire        rx_valid;
    wire        w_halted;
    localparam S_LOAD_WRITE = 5'd15;

    wire        io_sel = (w_mem_addr[15:8] == 8'hFF);
    assign pc_inc       = w_pc_inc;
    assign write_reg_en = w_write_reg_en;
    assign reg_addr     = w_reg_addr;
    assign reg_data     = w_reg_data;
    assign reg_q_out    = w_reg_q_out;
    assign halted       = w_halted;

    always @(posedge clk)begin

        if(rst) begin
            io_out <=0;
        end else if (w_mem_we && io_sel && (w_mem_addr == 16'hFF00))begin
            io_out <=w_mem_wdata;
        end

    end
    always @(posedge clk)begin
        io_sel_q <=io_sel;
        io_in_q <= io_in;
        io_addr_q <= w_mem_addr[7:0];
    end

    always @(posedge clk)begin
        if(rst)begin
            rx_data <=0;
            rx_ready <=0;
        end else if(rx_valid)begin
            rx_data <=rx_byte;
            rx_ready <=1;
        end else if(state_out == S_LOAD_WRITE && io_sel_q && io_addr_q == 8'h03)begin
            rx_ready <=0;
        end

    end


    always @* begin
        if (!io_sel_q) w_mem_rdata = ram_dout;
        else case (io_addr_q)
            8'h02: w_mem_rdata = {15'b0, uart_busy};
            8'h03: w_mem_rdata = {8'b0, rx_data};
            8'h04: w_mem_rdata = {15'b0, rx_ready};
            default: w_mem_rdata = io_in_q;
        endcase
    end
    assign uart_start = w_mem_we && (w_mem_addr == 16'hFF01) && !uart_busy;



    uart_tx u_uart(
        .clk(clk),
        .rst(rst),
        .data(w_mem_wdata[7:0]),
        .start(uart_start),
        .tx(uart_tx_pin),
        .busy(uart_busy)
    );
    // Instancia Control Unit
    controlunit cu_inst (
        .clk(clk),
        .rst(rst),
        .rom_data(rom_data),
        .reg_read_data(w_reg_q_out),
        .z_flag(w_z_flag),
        .c_flag(w_c_flag),
        .n_flag(w_n_flag),
        .alu_a(w_alu_a),
        .alu_result(w_alu_out),
        .alu_op(w_alu_op),
        .pc_inc(w_pc_inc),
        .write_reg_en(w_write_reg_en),
        .reg_addr(w_reg_addr),
        .reg_data(w_reg_data),
        .state_out(state_out),
        .pc_load(w_pc_load),
        .pc_addr(w_pc_addr),
        .mem_addr(w_mem_addr),
        .mem_wdata(w_mem_wdata),
        .mem_we(w_mem_we),
        .mem_rdata(w_mem_rdata),
        .halted(w_halted)
    );

    // Instancia Register File
    register_file rf_inst (
        .clk(clk),
        .rst_n(~rst),
        .addr(w_reg_addr),
        .d_in(w_reg_data),
        .write_en(w_write_reg_en),
        .q_out(w_reg_q_out),
        .r1_out(w_alu_op)
    );

    // Instancia ALU
    alu alu_inst (
        .a(w_alu_a),
        .b(w_reg_q_out),
        .op(w_alu_op),
        .out(w_alu_out),
        .z_flag(w_z_flag),
        .c_flag(w_c_flag),
        .n_flag(w_n_flag)
    );
    programcounter programcounter_inst(
        .clk(clk),
        .rst(rst),
        .pc_inc(w_pc_inc),
        .pc_load(w_pc_load),
        .d_in(w_pc_addr),
        .pc(pc)
    );
    data_ram ram_inst(
        .clk(clk),
        .addr(w_mem_addr[11:0]),
        .din(w_mem_wdata),
        .we(w_mem_we && !io_sel),
        .dout(ram_dout)
    );
    uart_rx u_uart_rx(
        .clk(clk),
        .rst(rst),
        .rx(uart_rx_pin),
        .data(rx_byte),
        .valid(rx_valid)
        );


endmodule
