krivanikm/mnpk01-soc/rtl/control-unit/controlunit.sv

    `define OP_NOP   4'h0
    `define OP_MVI   4'h1
    `define OP_MOV   4'h2
    `define OP_MVIB  4'h3
    `define OP_LOAD  4'h4
    `define OP_STORE 4'h5
    `define OP_JMP   4'h6
    `define OP_ALU   4'h7
    `define OP_HLT   4'h8

    

    module controlunit (
        input  wire        clk,
        input  wire        rst,
        input  wire [15:0] rom_data,
        input wire [15:0] reg_read_data,
        input wire z_flag,
        input wire c_flag,
        input wire n_flag,
        input wire [15:0] alu_result,
        input wire [3:0] alu_op,
        output reg [15:0] alu_a,
        output reg         pc_inc,
        output reg         pc_load,
        output reg [15:0]  pc_addr,
        output reg  [1:0]  write_reg_en,    // [1] = horný bajt, [0] = dolný bajt, 2'b11 = celé slovo
        output reg  [3:0]  reg_addr,
        output reg  [15:0] reg_data,        // dáta pre zápis do registra
        output wire [4:0]  state_out,
        output reg  [15:0] mem_addr,
        output reg  [15:0] mem_wdata,
        output reg mem_we,
        input wire [15:0] mem_rdata,
        output wire         halted
    );

        typedef enum reg [4:0] {
        S_FETCH,
        S_DECODE,
        S_NOP,

        S_MVI_WRITE,

        S_MOV_LATCH,
        S_MOV_WRITE,

        S_ALU_A,
        S_ALU_B,

        S_JMP,
        S_JMP_WAIT1,
        S_JMP_WAIT2,

        S_STORE_ADDR,
        S_STORE_DATA,

        S_LOAD_ADDR,
        S_LOAD_WAIT,
        S_LOAD_WRITE,

        S_HLT

        }state_t;

        state_t state;

        reg [15:0] ir; 
        reg [15:0] temp_reg;
        reg [2:0] flags;            // [2] = Z, [1] = C, [0] = N

        
        reg cond_ok;

        always @(*) begin
            case (ir[11:8])
                4'b0000: cond_ok = 1'b1;        // JMP  – vždy
                4'b0001: cond_ok = flags[2];    // JZ   – Z = 1  (po CMP: a == b)
                4'b0010: cond_ok = !flags[2];   // JNZ  – Z = 0  (po CMP: a != b)
                4'b0011: cond_ok = flags[1];    // JC   – C = 1  (po CMP: a >  b)
                4'b0100: cond_ok = !flags[1];   // JNC  – C = 0  (po CMP: a <= b)
                4'b0101: cond_ok = flags[0];    // JN   – N = 1  (po CMP: a <  b)
                4'b0110: cond_ok = !flags[0];   // JNN  – N = 0  (po CMP: a >= b)
                default: cond_ok = 1'b0;        
            endcase
        end

        
        assign state_out = state;

        assign halted = (state == S_HLT);

        always @(posedge clk or posedge rst) begin
            if (rst) begin
                state               <= S_FETCH;
                ir                  <= 16'h0000;
                pc_inc              <= 1'b0;
                write_reg_en        <= 2'b00;
                reg_addr            <= 4'h0;
                reg_data            <= 16'h0000;
                temp_reg            <= 16'h0000;
                flags               <= 3'b000;
                alu_a               <= 16'h0000;
                pc_load             <= 1'b0;
                pc_addr             <= 16'h0;
                mem_addr            <= 16'h0;
                mem_wdata           <= 16'h0;
                mem_we              <= 1'b0;
            end else begin
                pc_inc              <= 1'b0;
                write_reg_en        <= 2'b00;
                pc_load             <= 1'b0;
                pc_addr             <= 16'h0;
                mem_we <= 1'b0;

                case (state)
                    S_FETCH: begin
                        ir     <= rom_data;
                        state  <= S_DECODE;
                        pc_inc <=1;
                    end

                    S_DECODE: begin
                        case (ir[15:12])
                            `OP_MVI, `OP_MVIB:begin 
                                state <= S_MVI_WRITE;
                                end
                            `OP_MOV:begin
                                reg_addr<= ir[7:4];
                                state <= S_MOV_LATCH;
                                end
                            `OP_ALU: begin
                                reg_addr <= ir[11:8];
                                state <= S_ALU_A;
                             end
                            `OP_LOAD:begin
                                reg_addr <= ir[7:4]; 
                                state <= S_LOAD_ADDR;
                            end 
                            `OP_STORE: begin
                                reg_addr <= ir[7:4];
                                state <= S_STORE_ADDR;
                            end
                            `OP_JMP:begin 
                                state <= S_JMP;
                                reg_addr <= ir[7:4];
                            end
                            default:begin // NOP + neznámy opcode: prázdny takt, kým sa PC posunie
                                state <= S_NOP;
                            end
                            `OP_HLT: begin
                                state <=S_HLT;
                            end


                        endcase
                    end

                    S_NOP: begin
                        state <= S_FETCH;
                    end

                    S_MVI_WRITE: begin
                        reg_addr     <= ir[11:8];            // Adresa registra z [11:8]
                        reg_data     <= {ir[7:0], ir[7:0]};  // konštanta na oboch bajtoch, write_reg_en vyberie, ktorý sa zapíše
                        if (ir[15:12] == `OP_MVIB)
                            write_reg_en <= 2'b10;           // MVIB: horný bajt
                        else
                            write_reg_en <= 2'b01;           // MVI: dolný bajt
                        state        <= S_FETCH;
                    end
                    S_MOV_LATCH: begin
                        temp_reg <= reg_read_data;
                        reg_addr <= ir[11:8];
                        state <= S_MOV_WRITE;
                    end
                    S_MOV_WRITE: begin
                        write_reg_en <= 2'b11;
                        reg_data <= temp_reg;
                        state <= S_FETCH;
                    end
                    S_ALU_A: begin 
                        alu_a <= reg_read_data;
                        reg_addr <= ir[7:4];
                        state <= S_ALU_B;
                    end
                    S_ALU_B: begin
                        flags[2]<= z_flag;
                        flags[1]<= c_flag;
                        flags[0]<= n_flag;
                        if (alu_op != 4'b1011) begin
                            write_reg_en <= 2'b11;
                            reg_addr <= ir[3:0];
                            reg_data <= alu_result;
                        end
                        state <= S_FETCH;

                     end
                     S_JMP:begin
                        if(cond_ok)begin
                            pc_addr <= reg_read_data;
                            pc_load <= 1;
                            state <= S_JMP_WAIT1;
                        end
                        else begin
                            state <= S_FETCH;
                        end
                     end
                     S_JMP_WAIT1: begin
                        state <= S_JMP_WAIT2;
                     end
                     S_JMP_WAIT2:begin
                        state <= S_FETCH;
                     end
                     S_STORE_ADDR: begin 
                        mem_addr <= reg_read_data;
                        reg_addr <= ir[11:8];
                        state <= S_STORE_DATA;
                     end
                     S_STORE_DATA: begin
                        mem_wdata <= reg_read_data;
                        mem_we <= 1;
                        state <= S_FETCH;
                     end
                     S_LOAD_ADDR: begin 
                        mem_addr <= reg_read_data;
                        state <= S_LOAD_WAIT;
                     end
                     S_LOAD_WAIT: begin 
                        state<= S_LOAD_WRITE;
                     end
                     S_LOAD_WRITE: begin 
                        reg_addr <= ir[11:8];
                        reg_data <= mem_rdata;
                        write_reg_en <= 2'b11;
                        state <= S_FETCH;
                    end
                    S_HLT: begin
                        state <=S_HLT;
                    end

            




                    default: state <= S_FETCH;
                endcase
            end
        end
    endmodule
