krivanikm/mnpk01-soc/(commit log)

2026-09-07 started using risc architecture after consideration using spi flash
2026-10-09 schematics from yosys
2026-10-09 docs: fixes, schematics page, README status
2026-10-09 docs: zoomable schematic viewer, cache-busting
2026-10-09 docs: JMP, jump timing, schematics with PC
2026-10-11 docs: LOAD/STORE, memory map, RAM schematic
2026-10-22 FPGA top for Tang Nano 9K: CPU with IO port, DIP to LED program
2026-10-22 docs: I/O port, 24 tests, FPGA page, regenerated system_top schematics
2026-10-25 UART TX: uart_tx module, MMIO at 0xFF01/0xFF02, testbench, Hello World on Tang Nano 9K
2026-10-28 UART RX: uart_rx module, MMIO at 0xFF03/0xFF04, testbenches
2026-10-28 docs: UART and I/O updates
2026-10-28 FPGA: UART RX pin, echo program, keep Hello World as prog_hello.hex
2026-10-28 docs: UART receiver, memory map, echo program, 28 tests
2026-11-02 Bootloader: MNPK sync, length, program words over UART, testbench
2026-11-08 HLT instruction (opcode 0x8), halted LED on FPGA
2026-11-08 mnasm assembler, counter program
2026-11-11 docs: HLT and assembler done, UART bootloader instead of SPI flash
