krivanikm/mnpk01-soc/(notices)

Notices in the files:
README.md:
License: GPLv3
